Aboodik/updated-micro-controller/Thor_Power_System_RP2040/Thor_MCU_RP2040.kicad_sch

## KiCad design Thor_Power_System_RP2040/Thor_MCU_RP2040.kicad_sch (2026-11-03)

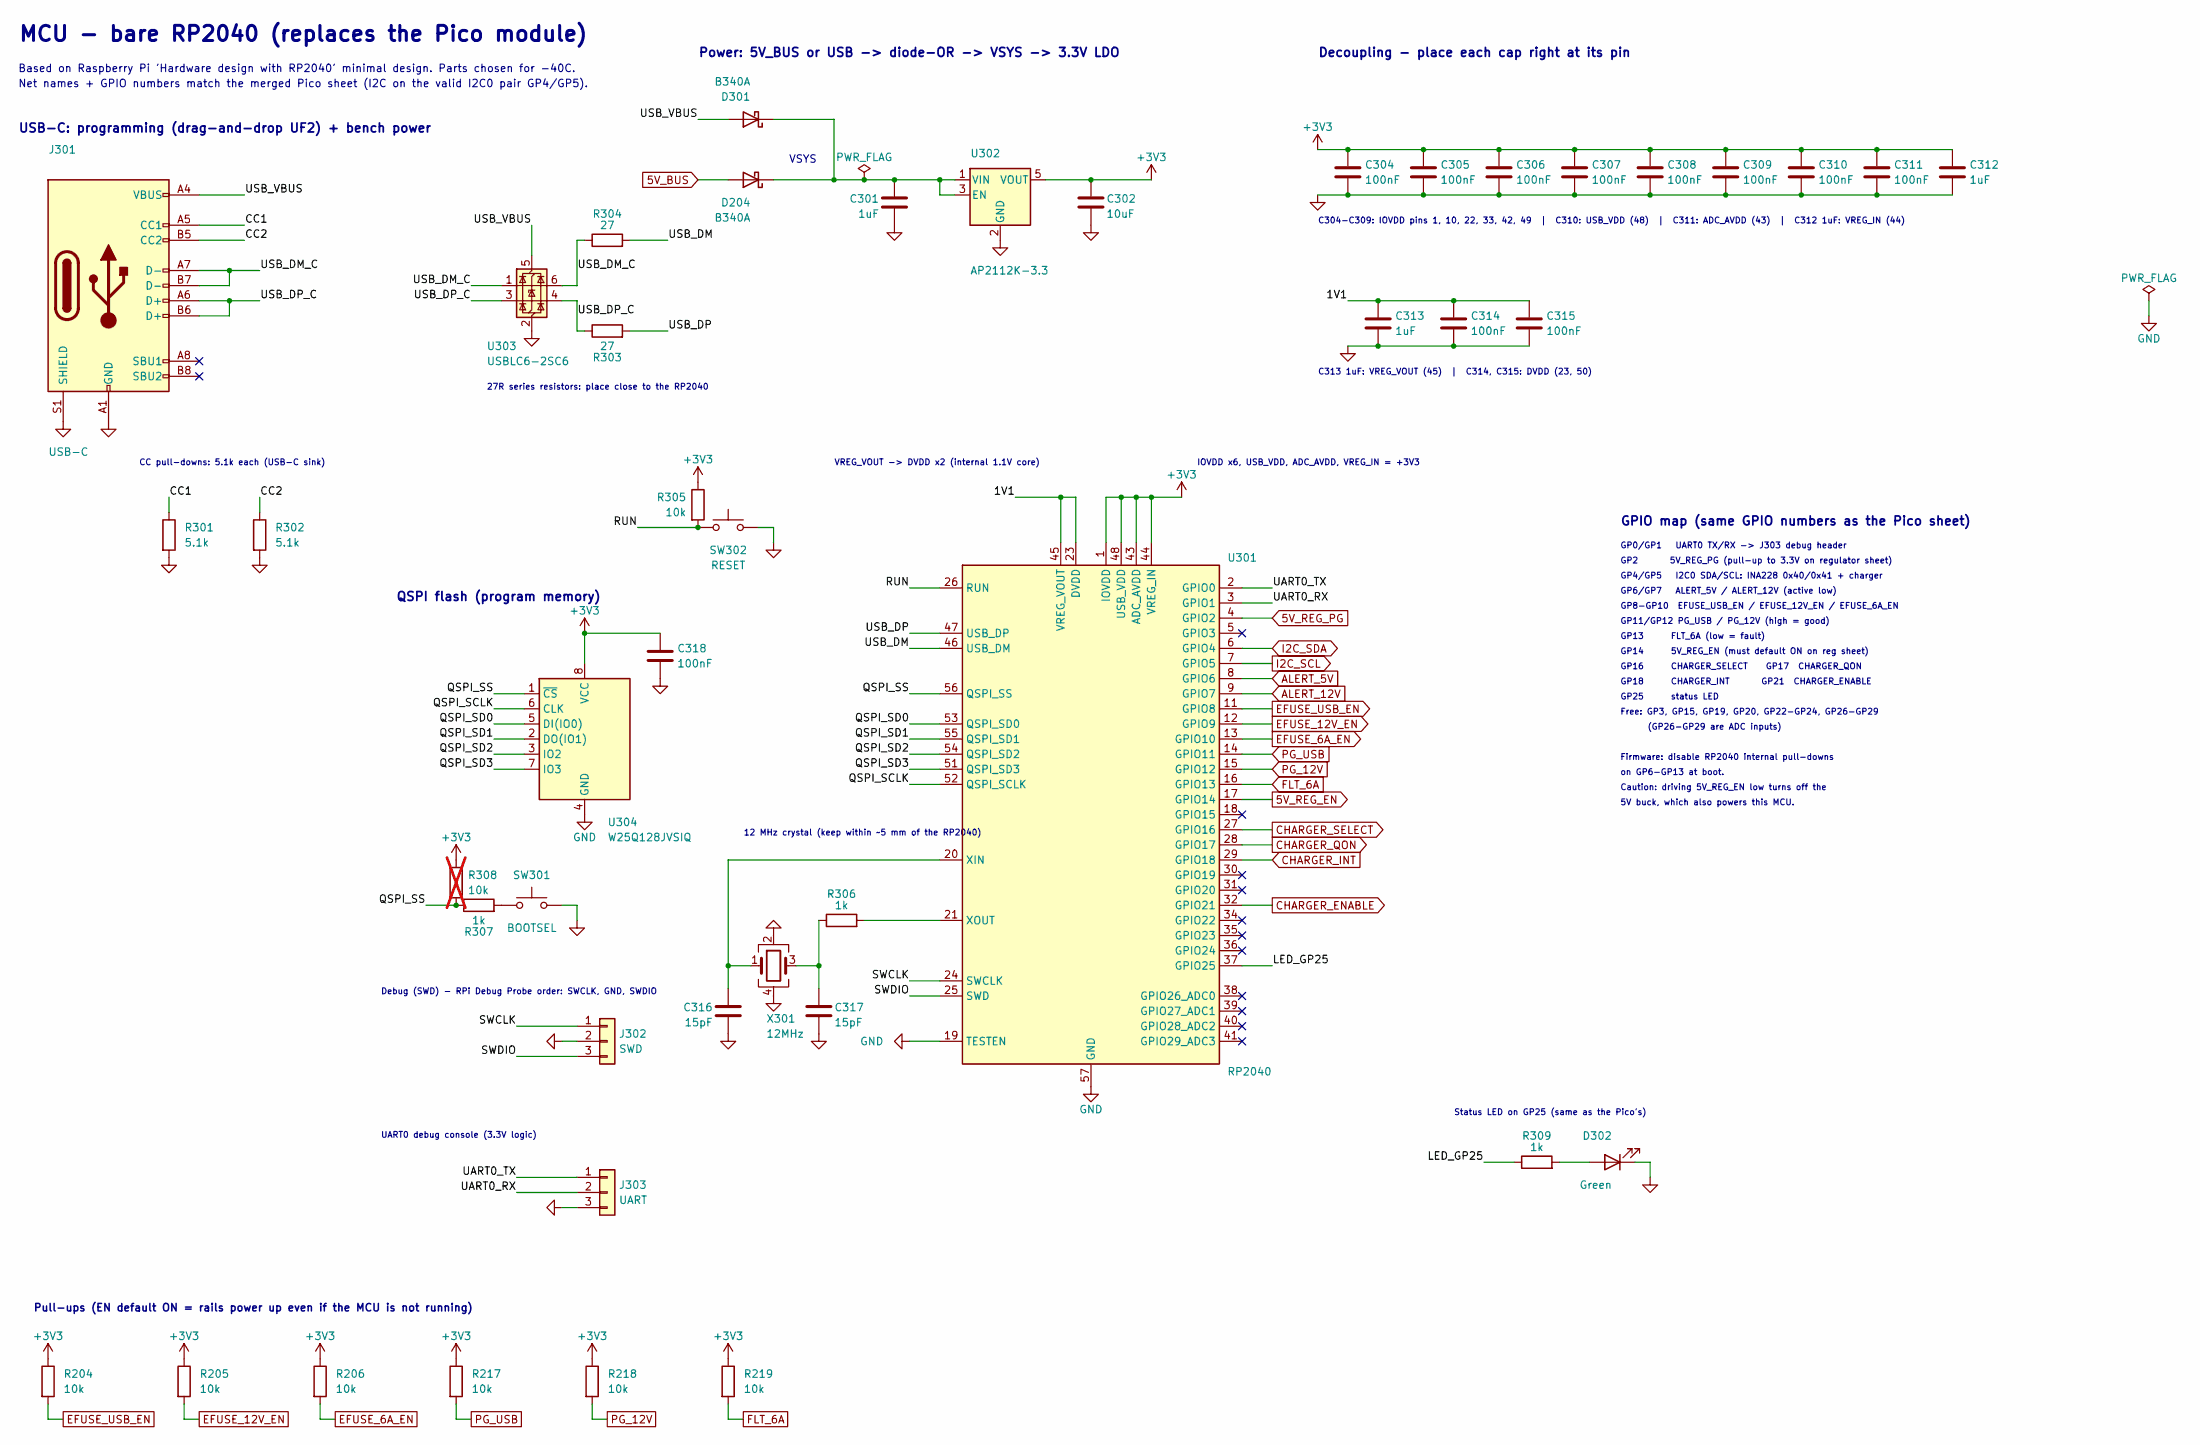
[picture p5: schematic Thor_MCU_RP2040.kicad_sch]

Parts:
C301, C312, C313: 1uF; C_0603_1608Metric; MPN GRM188R71C105KA12D
C302: 10uF; C_0805_2012Metric; MPN GRM21BR61C106KE15L
C304, C305, C306, C307, C308, C309, C310, C311, C314, C315, C318: 100nF; C_0603_1608Metric; MPN GRM188R71C104KA01D
C316, C317: 15pF; C_0603_1608Metric; MPN GRM1885C1H150JA01D
D204, D301: B340A; D_SMA; MPN B340A-13-F
D302: Green; LED_0603_1608Metric; MPN LTST-C191KGKT
J301: USB-C; USB_C_Receptacle_GCT_USB4105-xx-A_16P_TopMnt_Horizontal; MPN USB4105-GF-A
J302: SWD; PinHeader_1x03_P2.54mm_Vertical
J303: UART; PinHeader_1x03_P2.54mm_Vertical
R204, R205, R206, R217, R218, R219, R305: 10k; R_0603_1608Metric; MPN RC0603FR-0710KL
R301, R302: 5.1k; R_0603_1608Metric; MPN RC0603FR-075K1L
R303, R304: 27; R_0603_1608Metric; MPN RC0603FR-0727RL
R306, R307, R309: 1k; R_0603_1608Metric; MPN RC0603FR-071KL
R308: 10k; R_0603_1608Metric; MPN RC0603FR-0710KL; not fitted
SW301: BOOTSEL; SW_SPST_TL3342; MPN TL3342F160QG
SW302: RESET; SW_SPST_TL3342; MPN TL3342F160QG
U301: RP2040; QFN-56-1EP_7x7mm_P0.4mm_EP3.2x3.2mm; MPN RP2040
U302: AP2112K-3.3; SOT-23-5; MPN AP2112K-3.3TRG1
U303: USBLC6-2SC6; SOT-23-6; MPN USBLC6-2SC6
U304: W25Q128JVSIQ; SOIC-8_5.23x5.23mm_P1.27mm; MPN W25Q128JVSIQ
X301: 12MHz; Crystal_SMD_3225-4Pin_3.2x2.5mm; MPN ABM8-272-T3

Connections:
1V1: C313.1, C314.1, C315.1, U301.23 (DVDD), U301.45 (VREG_VOUT), U301.50 (DVDD)
5V_BUS: D204.2 (A)
5V_REG_EN: U301.17 (GPIO14)
5V_REG_PG: U301.4 (GPIO2)
+3V3: C302.1, C304.1, C305.1, C306.1, C307.1, C308.1, C309.1, C310.1, C311.1, C312.1, C318.1, R204.1, R205.1, R206.1, R217.1, R218.1, R219.1, R305.1, R308.1, U301.1 (IOVDD), U301.10 (IOVDD), U301.22 (IOVDD), U301.33 (IOVDD), U301.42 (IOVDD), U301.43 (ADC_AVDD), U301.44 (VREG_IN), U301.48 (USB_VDD), U301.49 (IOVDD), U302.5 (VOUT), U304.8 (VCC)
ALERT_5V: U301.8 (GPIO6)
ALERT_12V: U301.9 (GPIO7)
CC1: J301.A5 (CC1), R301.1
CC2: J301.B5 (CC2), R302.1
CHARGER_ENABLE: U301.32 (GPIO21)
CHARGER_INT: U301.29 (GPIO18)
CHARGER_QON: U301.28 (GPIO17)
CHARGER_SELECT: U301.27 (GPIO16)
EFUSE_6A_EN: R206.2, U301.13 (GPIO10)
EFUSE_12V_EN: R205.2, U301.12 (GPIO9)
EFUSE_USB_EN: R204.2, U301.11 (GPIO8)
FLT_6A: R219.2, U301.16 (GPIO13)
GND: C301.2, C302.2, C304.2, C305.2, C306.2, C307.2, C308.2, C309.2, C310.2, C311.2, C312.2, C313.2, C314.2, C315.2, C316.2, C317.2, C318.2, D302.1 (K), J301.A1 (GND), J301.A12 (GND), J301.B1 (GND), J301.B12 (GND), J301.S1 (SHIELD), J302.2, J303.3, R301.2, R302.2, SW301.2, SW302.2, U301.19 (TESTEN), U301.57 (GND), U302.2 (GND), U303.2 (GND), U304.4 (GND), X301.2, X301.4
I2C_SCL: U301.7 (GPIO5)
I2C_SDA: U301.6 (GPIO4)
LED_GP25: R309.1, U301.37 (GPIO25)
unnamed: C301.1, D204.1 (K), D301.1 (K), U302.1 (VIN), U302.3 (EN)
unnamed: C316.1, U301.20 (XIN), X301.1
unnamed: C317.1, R306.1, X301.3
unnamed: D302.2 (A), R309.2
unnamed: R306.2, U301.21 (XOUT)
unnamed: R307.2, SW301.1
PG_12V: R218.2, U301.15 (GPIO12)
PG_USB: R217.2, U301.14 (GPIO11)
QSPI_SCLK: U301.52 (QSPI_SCLK), U304.6 (CLK)
QSPI_SD0: U301.53 (QSPI_SD0), U304.5 (DI(IO0))
QSPI_SD1: U301.55 (QSPI_SD1), U304.2 (DO(IO1))
QSPI_SD2: U301.54 (QSPI_SD2), U304.3 (IO2)
QSPI_SD3: U301.51 (QSPI_SD3), U304.7 (IO3)
QSPI_SS: R307.1, R308.2, U301.56 (QSPI_SS), U304.1 (~CS)
RUN: R305.2, SW302.1, U301.26 (RUN)
SWCLK: J302.1, U301.24 (SWCLK)
SWDIO: J302.3, U301.25 (SWD)
UART0_RX: J303.2, U301.3 (GPIO1)
UART0_TX: J303.1, U301.2 (GPIO0)
USB_DM: R304.2, U301.46 (USB_DM)
USB_DM_C: J301.A7 (D-), J301.B7 (D-), R304.1, U303.1 (I/O1), U303.6 (I/O1)
USB_DP: R303.2, U301.47 (USB_DP)
USB_DP_C: J301.A6 (D+), J301.B6 (D+), R303.1, U303.3 (I/O2), U303.4 (I/O2)
USB_VBUS: D301.2 (A), J301.A4 (VBUS), J301.A9 (VBUS), J301.B4 (VBUS), J301.B9 (VBUS), U303.5 (VBUS)

Notes on the sheet:
MCU - bare RP2040 (replaces the Pico module)
Based on Raspberry Pi 'Hardware design with RP2040' minimal design. Parts chosen for -40C.
Net names + GPIO numbers match the merged Pico sheet (I2C on the valid I2C0 pair GP4/GP5).
12 MHz crystal (keep within ~5 mm of the RP2040)
IOVDD x6, USB_VDD, ADC_AVDD, VREG_IN = +3V3
VREG_VOUT -> DVDD x2 (internal 1.1V core)
USB-C: programming (drag-and-drop UF2) + bench power
CC pull-downs: 5.1k each (USB-C sink)
27R series resistors: place close to the RP2040
Power: 5V_BUS or USB -> diode-OR -> VSYS -> 3.3V LDO
VSYS
Decoupling - place each cap right at its pin
C304-C309: IOVDD pins 1, 10, 22, 33, 42, 49 | C310: USB_VDD (48) | C311: ADC_AVDD (43) | C312 1uF: VREG_IN (44)
C313 1uF: VREG_VOUT (45) | C314, C315: DVDD (23, 50)
QSPI flash (program memory)
Debug (SWD) - RPi Debug Probe order: SWCLK, GND, SWDIO
UART0 debug console (3.3V logic)
Status LED on GP25 (same as the Pico's)
Pull-ups (EN default ON = rails power up even if the MCU is not running)
GPIO map (same GPIO numbers as the Pico sheet)
GP0/GP1 UART0 TX/RX -> J303 debug header
GP2 5V_REG_PG (pull-up to 3.3V on regulator sheet)
GP4/GP5 I2C0 SDA/SCL: INA228 0x40/0x41 + charger
GP6/GP7 ALERT_5V / ALERT_12V (active low)
GP8-GP10 EFUSE_USB_EN / EFUSE_12V_EN / EFUSE_6A_EN
GP11/GP12 PG_USB / PG_12V (high = good)
GP13 FLT_6A (low = fault)
GP14 5V_REG_EN (must default ON on reg sheet)
GP16 CHARGER_SELECT GP17 CHARGER_QON
GP18 CHARGER_INT GP21 CHARGER_ENABLE
GP25 status LED
Free: GP3, GP15, GP19, GP20, GP22-GP24, GP26-GP29
(GP26-GP29 are ADC inputs)
Firmware: disable RP2040 internal pull-downs
on GP6-GP13 at boot.
Caution: driving 5V_REG_EN low turns off the
5V buck, which also powers this MCU.
