Aboodik/updated-micro-controller/Thor_Power_System_RP2040/Thor_Monitor.kicad_sch

## KiCad design Thor_Power_System_RP2040/Thor_Monitor.kicad_sch (2026-11-03)

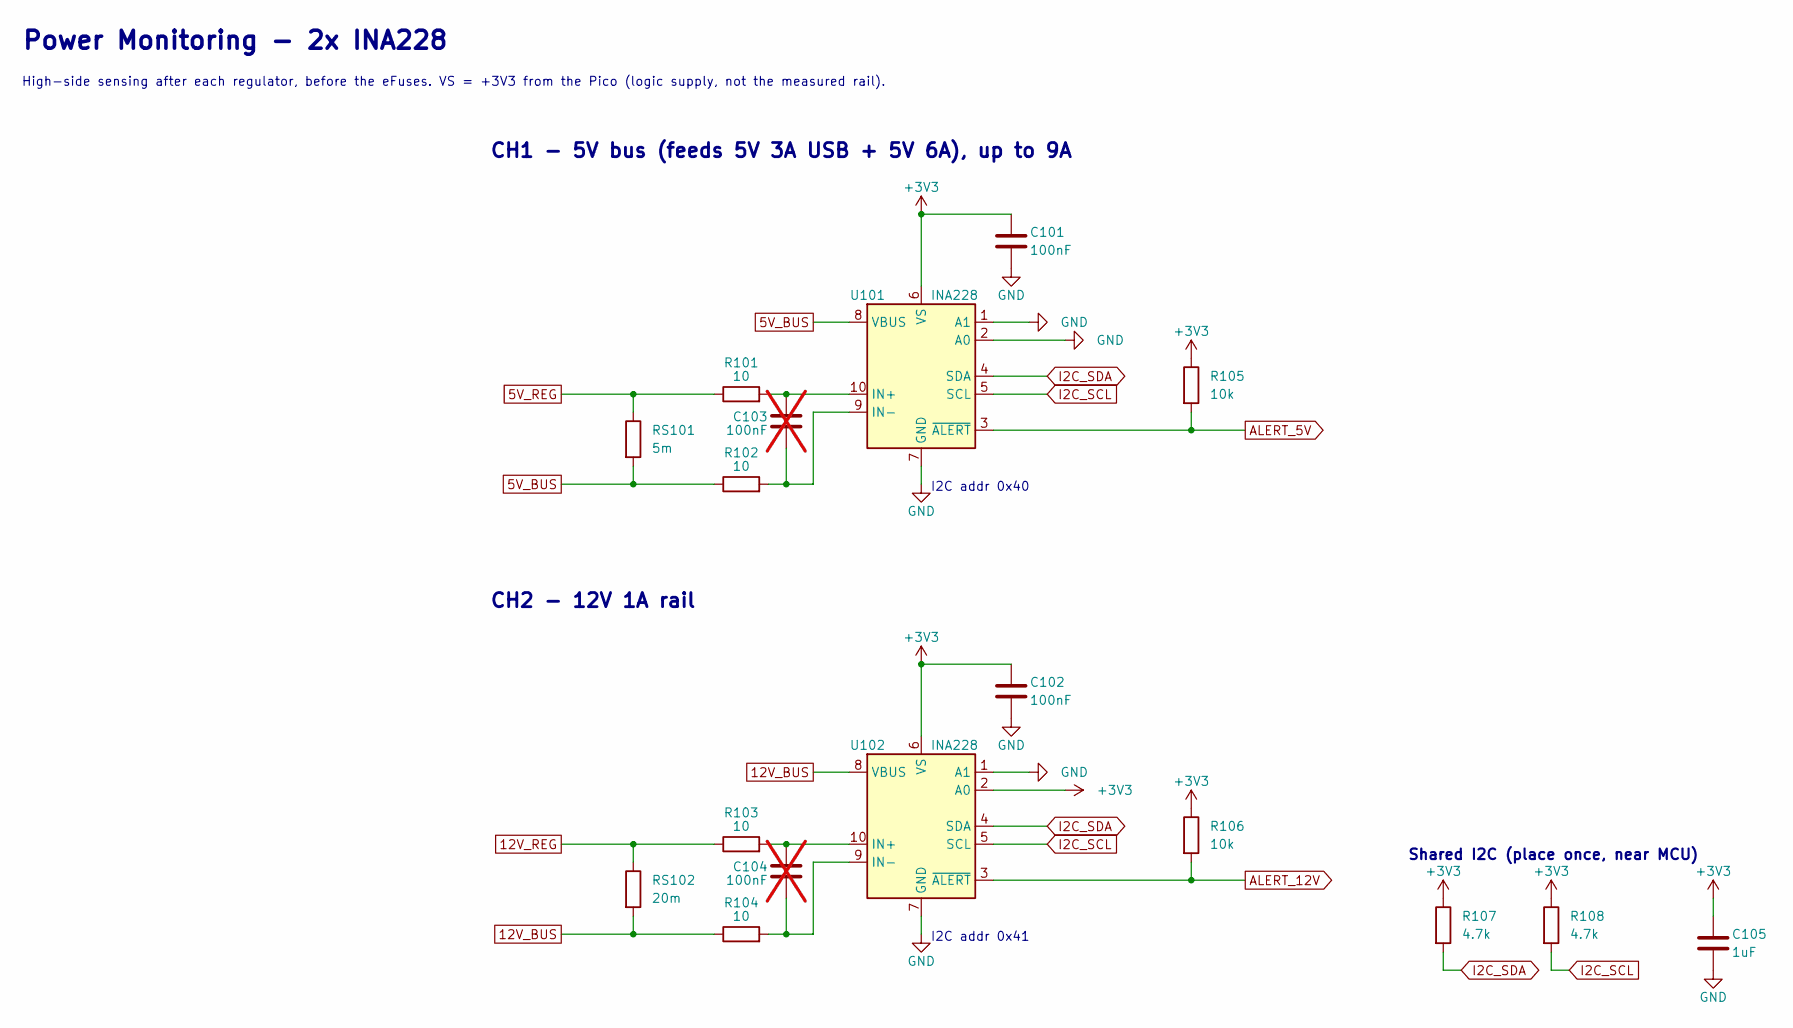
[picture p6: schematic Thor_Monitor.kicad_sch]

Parts:
C101, C102: 100nF; C_0603_1608Metric; MPN GRM188R71C104KA01D
C103, C104: 100nF; C_0603_1608Metric; MPN GRM188R71H104KA93D; not fitted
C105: 1uF; C_0603_1608Metric; MPN GRM188R71C105KA12D
R101, R102, R103, R104: 10; R_0603_1608Metric; MPN RC0603FR-0710RL
R105, R106: 10k; R_0603_1608Metric; MPN RC0603FR-0710KL
R107, R108: 4.7k; R_0603_1608Metric; MPN RC0603FR-074K7L
RS101: 5m; R_2512_6332Metric; MPN WSL25125L000FEA
RS102: 20m; R_1206_3216Metric; MPN WSL1206R0200FEA
U101, U102: INA228; VSSOP-10_3x3mm_P0.5mm; MPN INA228AIDGSR

Connections:
5V_BUS: R102.1, RS101.2, U101.8 (VBUS)
5V_REG: R101.1, RS101.1
12V_BUS: R104.1, RS102.2, U102.8 (VBUS)
12V_REG: R103.1, RS102.1
+3V3: C101.1, C102.1, C105.1, R105.1, R106.1, R107.1, R108.1, U101.6 (VS), U102.2 (A0), U102.6 (VS)
ALERT_5V: R105.2, U101.3 (~ALERT)
ALERT_12V: R106.2, U102.3 (~ALERT)
GND: C101.2, C102.2, C105.2, U101.1 (A1), U101.2 (A0), U101.7 (GND), U102.1 (A1), U102.7 (GND)
I2C_SCL: R108.2, U101.5 (SCL), U102.5 (SCL)
I2C_SDA: R107.2, U101.4 (SDA), U102.4 (SDA)
unnamed: C103.1, R101.2, U101.10 (IN+)
unnamed: C103.2, R102.2, U101.9 (IN-)
unnamed: C104.1, R103.2, U102.10 (IN+)
unnamed: C104.2, R104.2, U102.9 (IN-)

Notes on the sheet:
Power Monitoring - 2x INA228
High-side sensing after each regulator, before the eFuses. VS = +3V3 from the Pico (logic supply, not the measured rail).
CH1 - 5V bus (feeds 5V 3A USB + 5V 6A), up to 9A
I2C addr 0x40
CH2 - 12V 1A rail
I2C addr 0x41
Shared I2C (place once, near MCU)
